juanfran2018/Ofelia-Confinement-Shear-Cell/Design/Linear/LinearStage.pdf

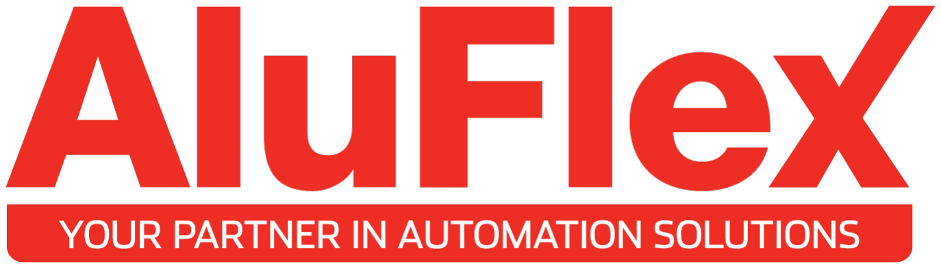
[picture p6: figure]

Artikelnummer

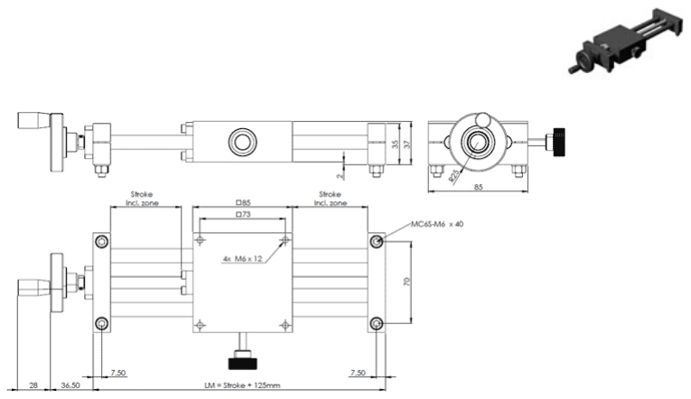
[picture p7: figure]

### JM12-S0040-TR-UR

Beskrivning

### Adjustment table JM12

Produktattribut | Värde
Trapetsgängadskruv | 10x3
Slaglängd (OBS! Inklusive överlöp) | 40
Med ratt | No

Created: 2019-04-03 13:17:58
Adress: | AluFlex System AB Lilla Garnisonsgatan 34 254 67 Helsingborg Skåne Sweden

Telefon:
Webb:
E-post:

042-380230
www.aluflex.se
orders@aluflex.se
