juanfran2018/Ofelia-Confinement-Shear-Cell/Images/ConfinementCell_3Dprinted.png

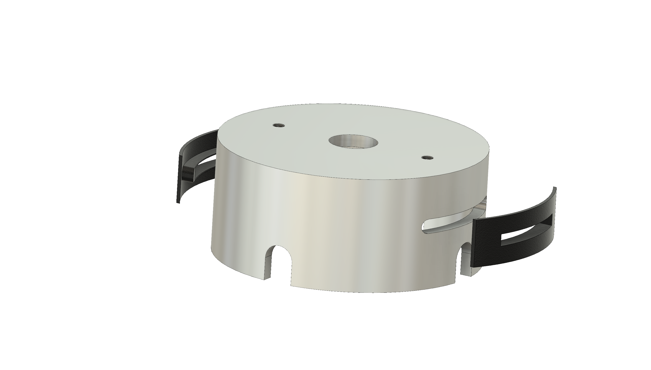
Images/ConfinementCell_3Dprinted.png
