juanfran2018/Ofelia-Confinement-Shear-Cell/Design/Linear/CaseWindow.pdf

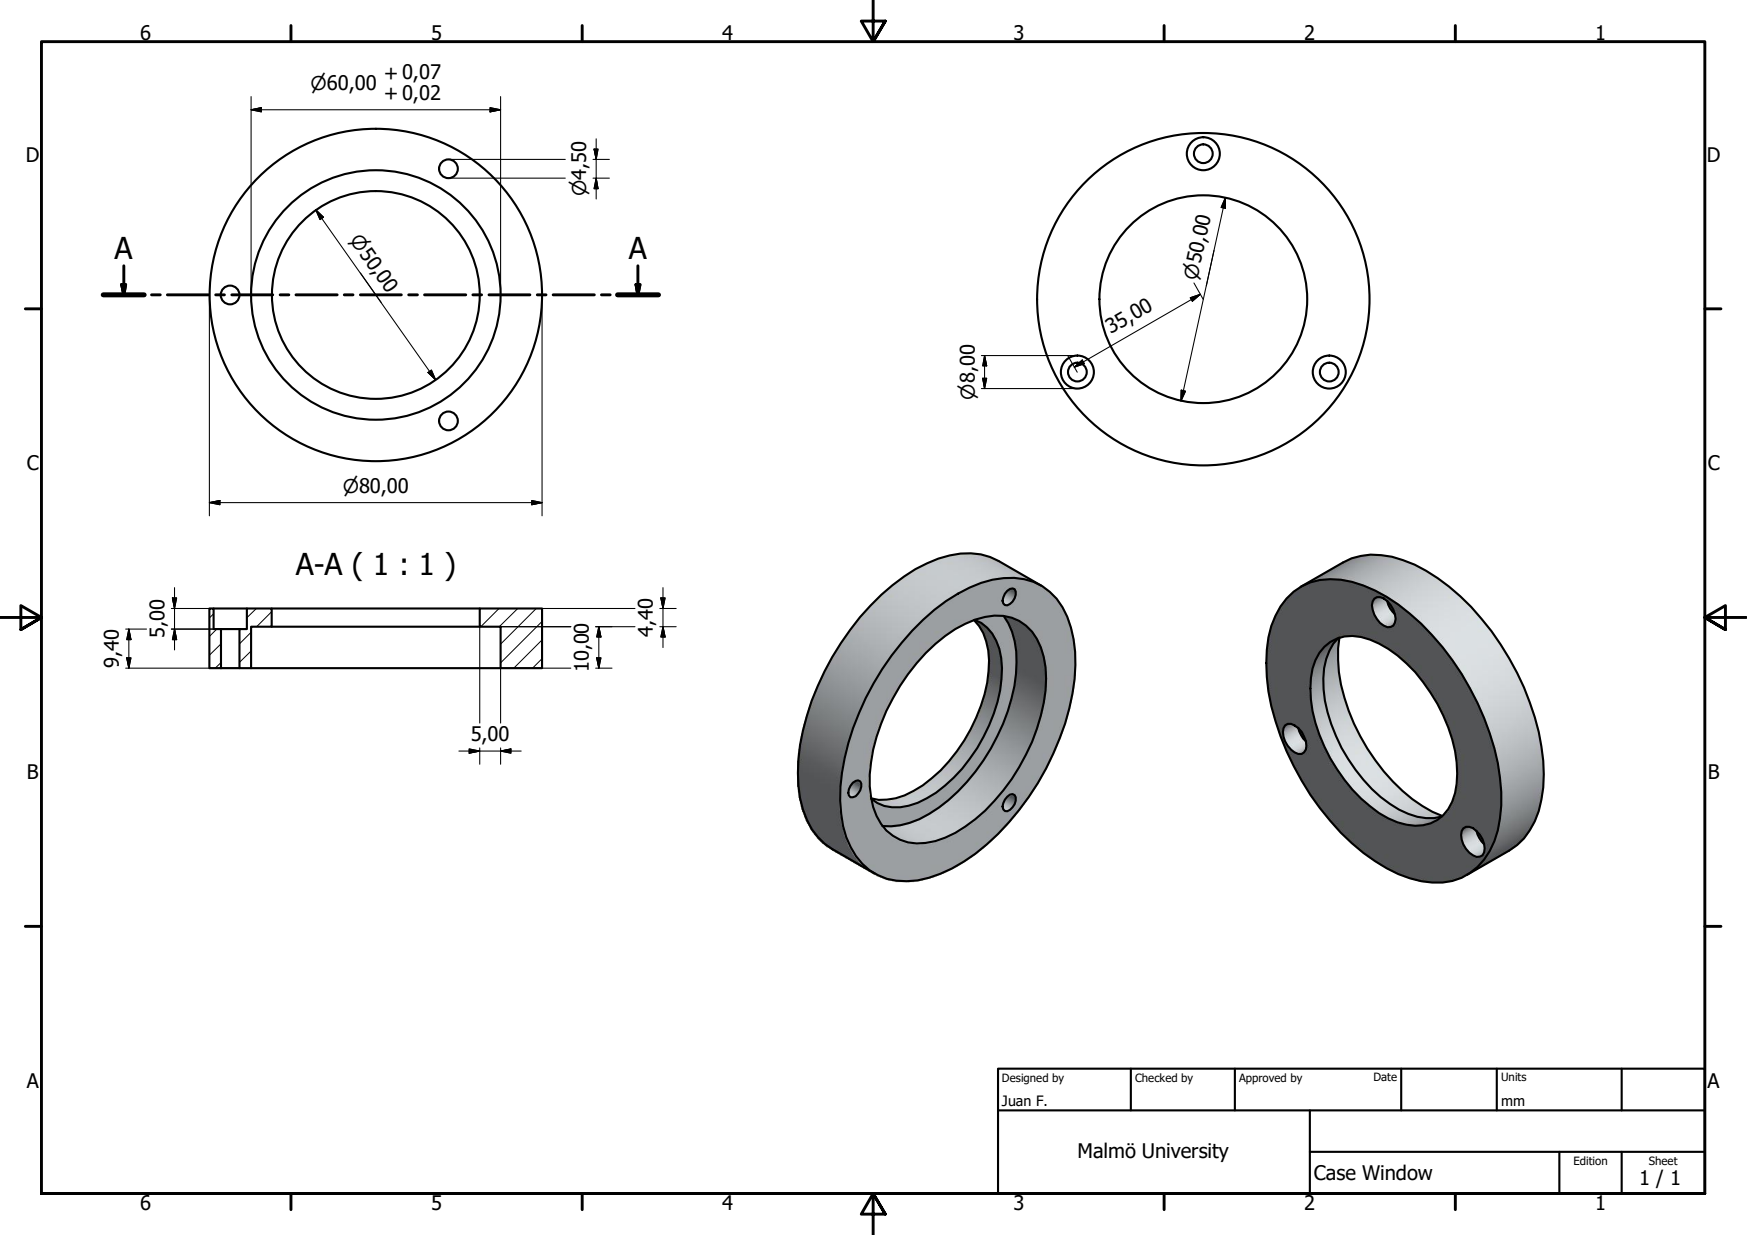
[picture p9: page 1]

Designed by Juan F. | Checked by | Approved by Date | Units mm

Malm| University

Case Window | Edition | Sheet 1 / 1
