juanfran2018/Ofelia-Confinement-Shear-Cell/Design/Linear/LinearCaseExternal.pdf

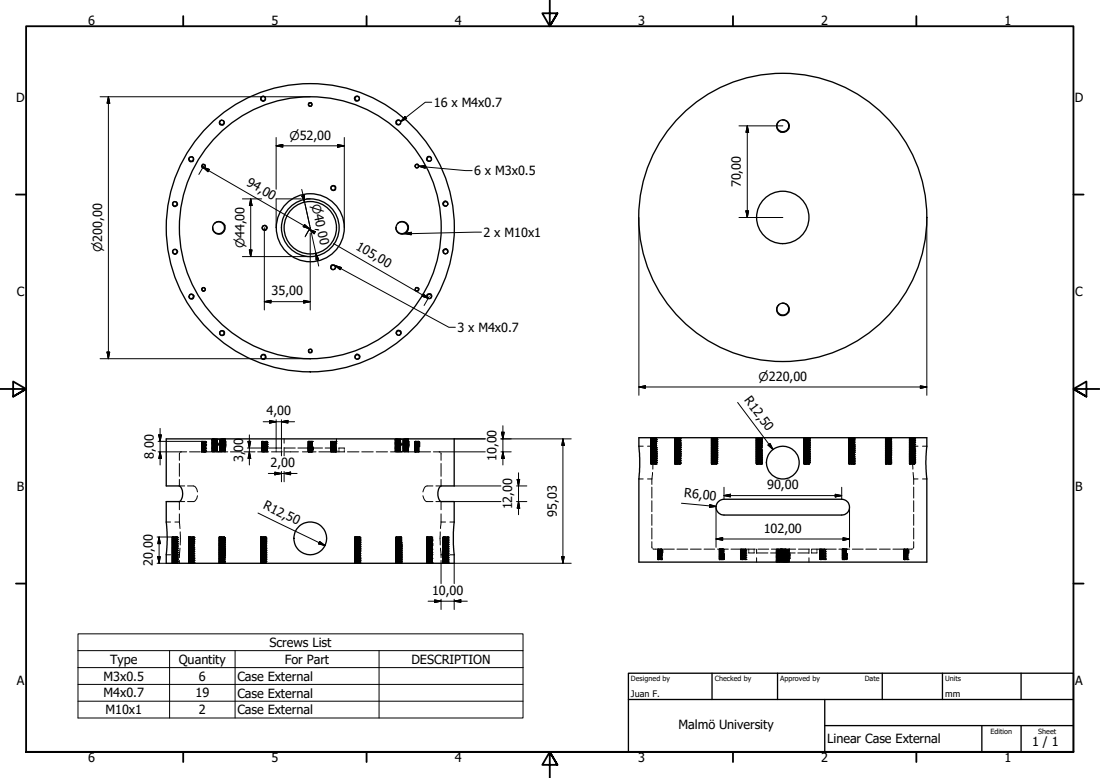
[picture p10: page 1]
Malmö University; Juan F.; Designed by; Checked by; Approved by; Units; Screws List; Type; Quantity; For Part; DESCRIPTION; Case External

Linear Case External
