juanfran2018/Ofelia-Confinement-Shear-Cell/Design/Linear/LinearCaseInternal.pdf

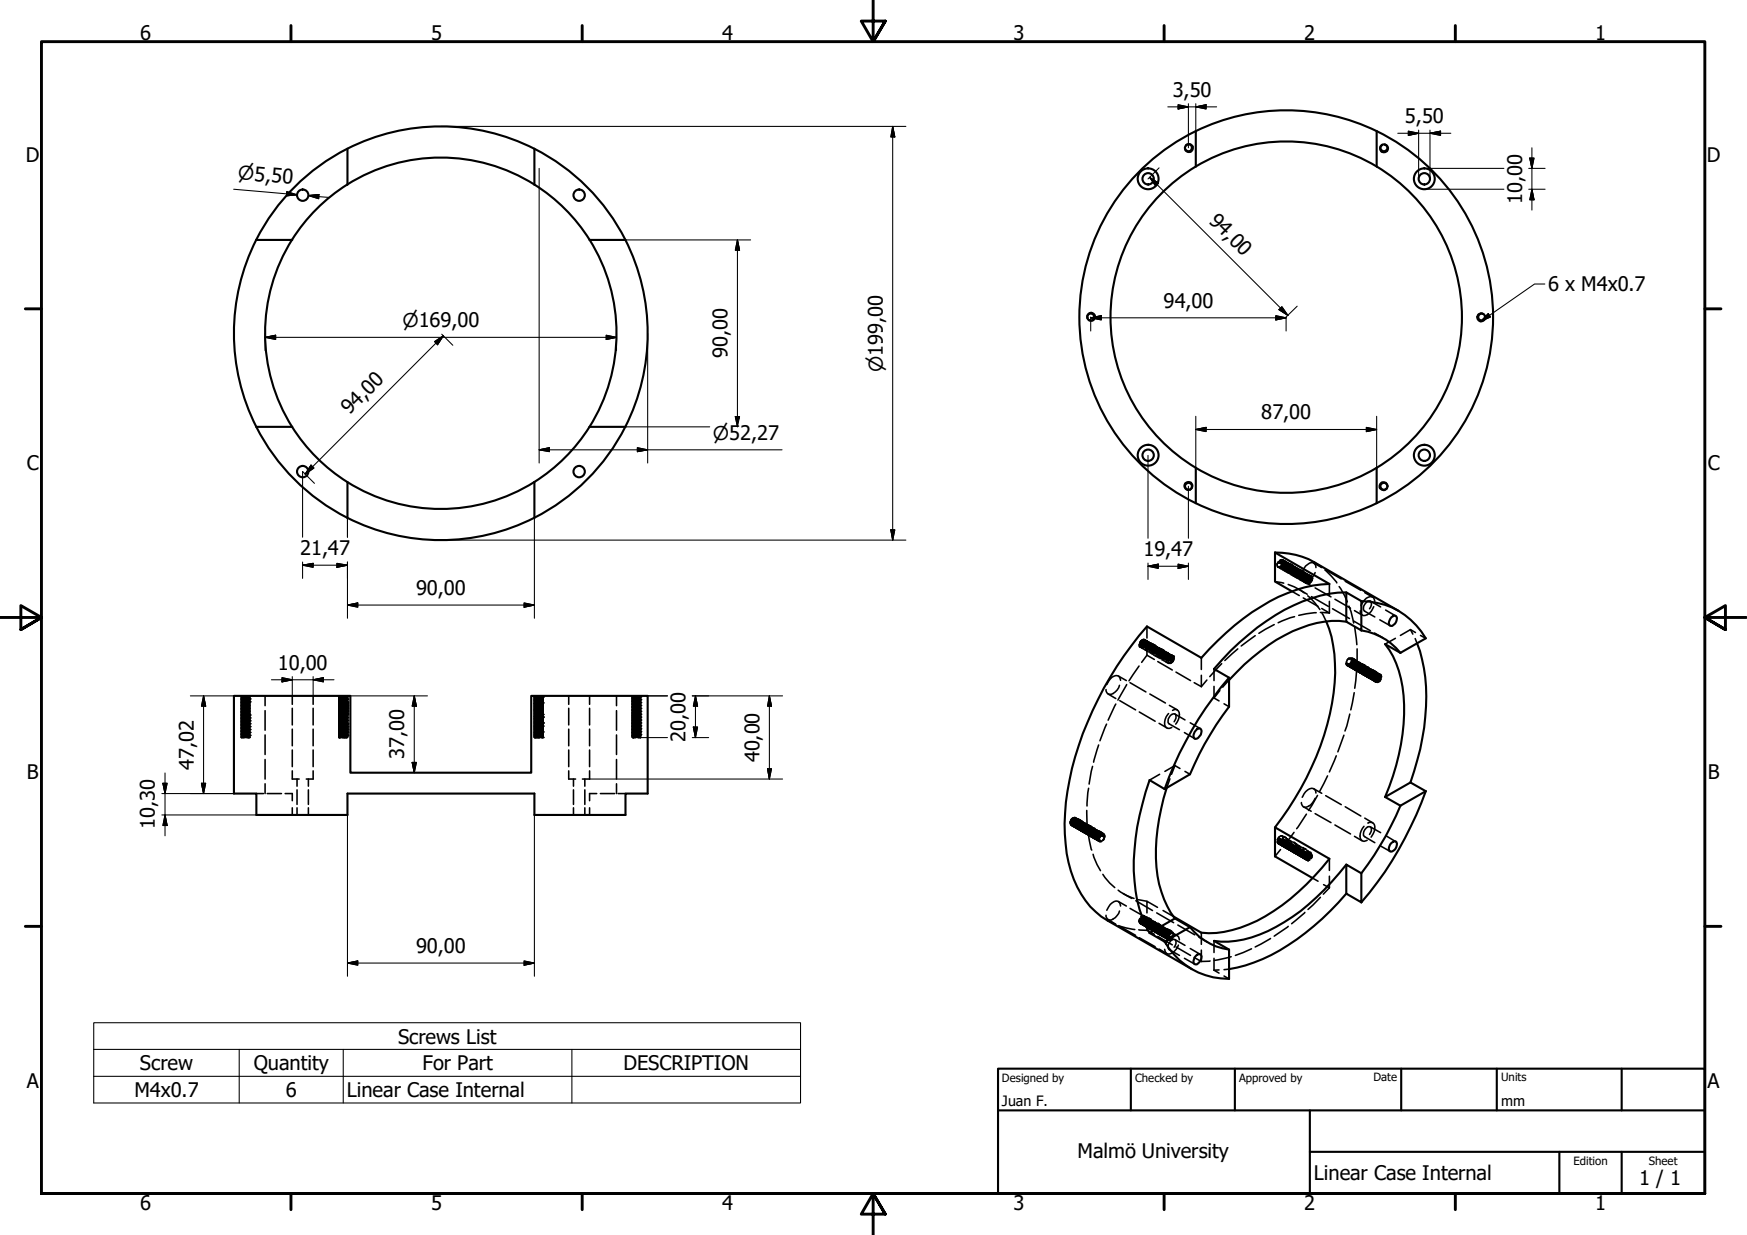
[picture p11: page 1]
Screws List

Screw | Quantity | For Part | DESCRIPTION
M4x0.7 | 6 | Linear Case Internal

Designed by Juan F. | Checked by | Approved by Date | Units mm

Malm| University

Linear Case Internal | Edition | Sheet 1 / 1
