juanfran2018/Ofelia-Confinement-Shear-Cell/Design/Linear/LinearCaseLidSink.pdf

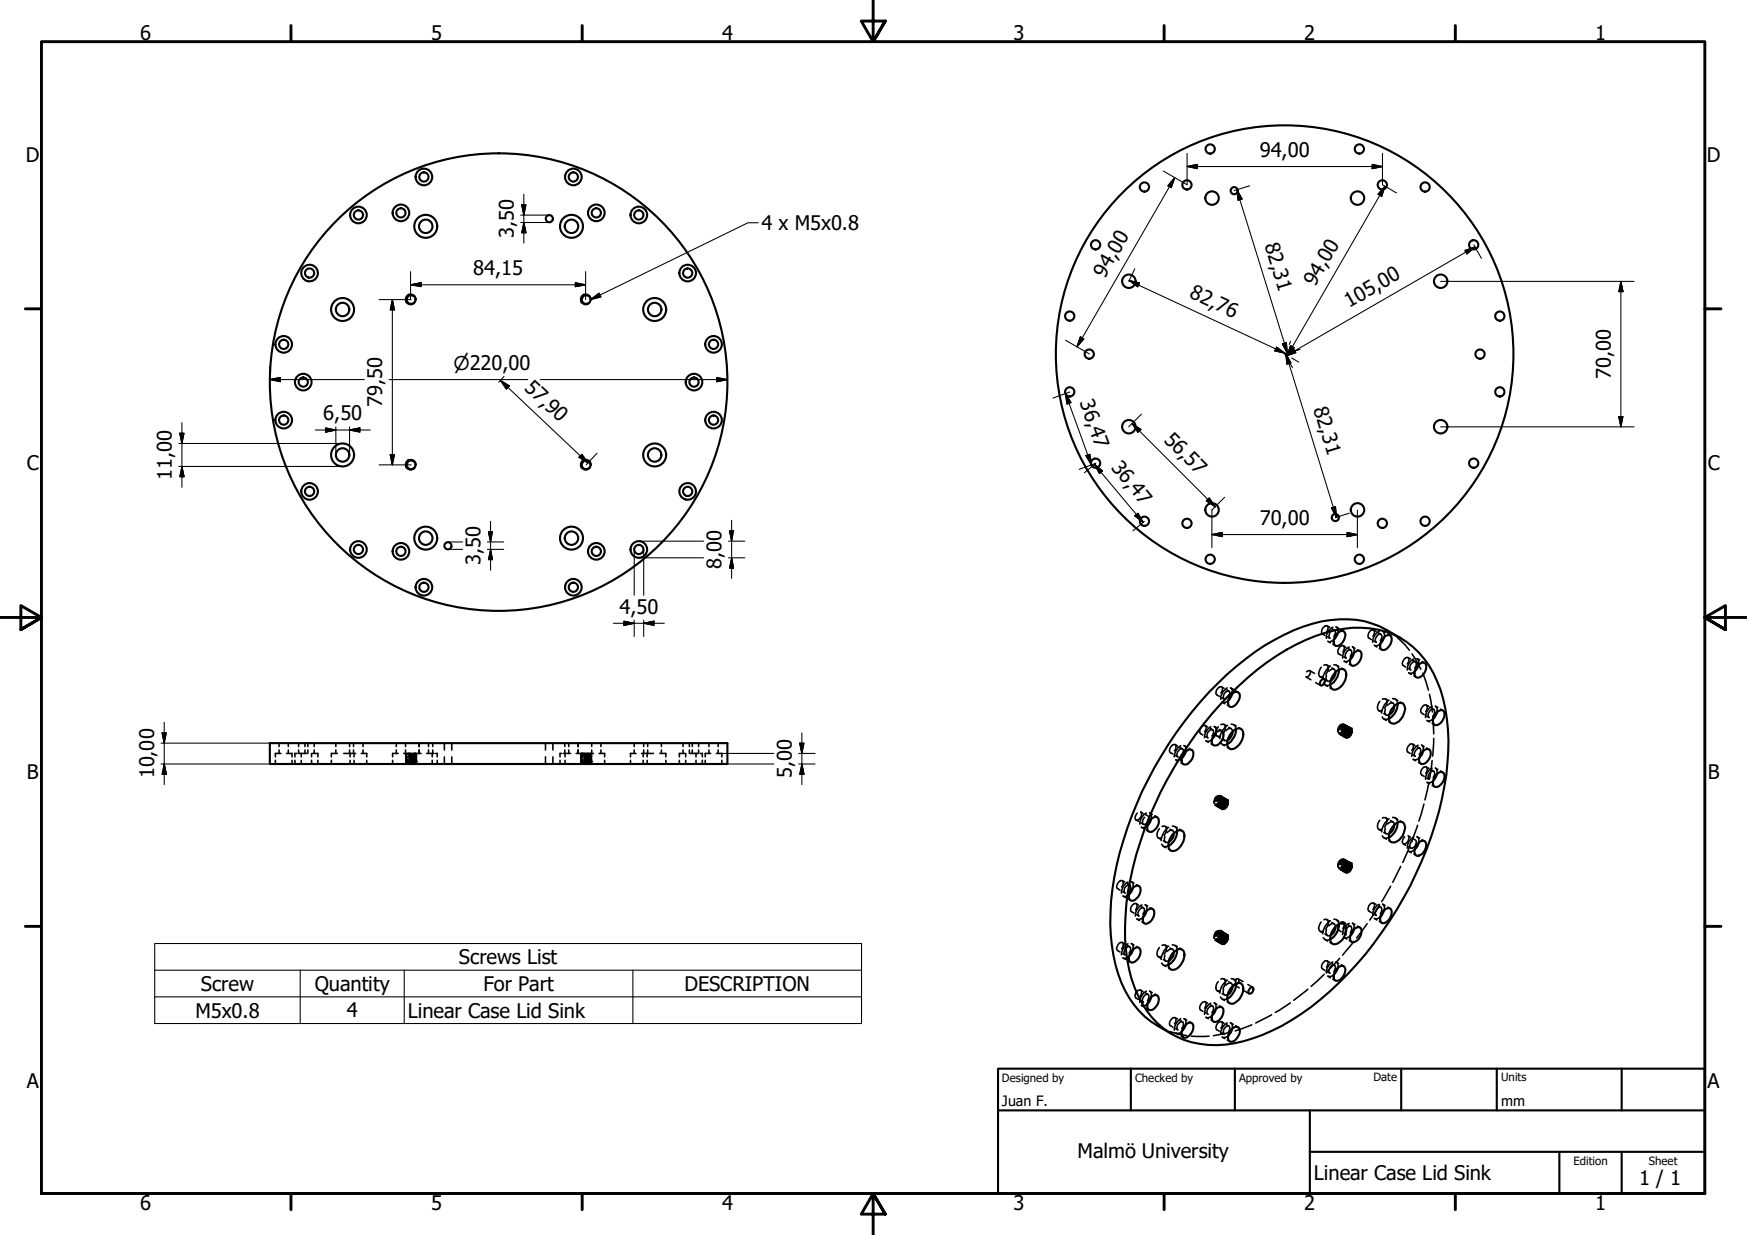
[picture p12: page 1]
Screws List

Screw | Quantity | For Part | DESCRIPTION
M5x0.8 | 4 | Linear Case Lid Sink

Designed by Juan F. | Checked by | Approved by Date | Units mm

Malm| University

Linear Case Lid Sink | Edition | Sheet 1 / 1
