juanfran2018/Ofelia-Confinement-Shear-Cell/Design/Linear/LinearSampleHolder.pdf

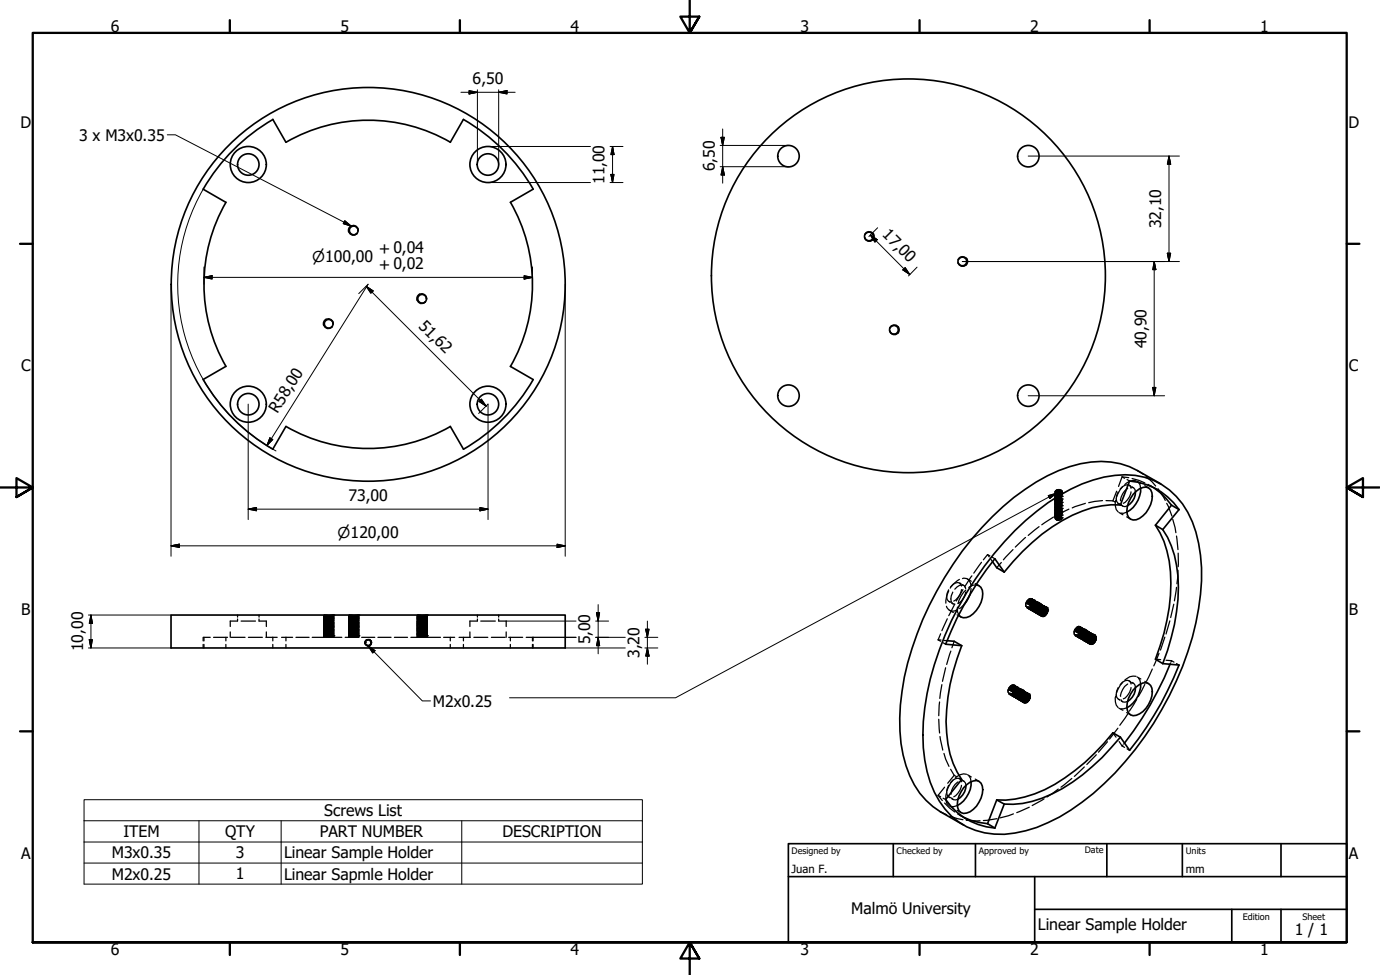
[picture p13: page 1]
Screws List; ITEM; QTY; PART NUMBER; DESCRIPTION; Linear Sample Holder; Linear Sapmle Holder; Juan F.; Designed by; Checked by; Approved by; Units

Malm| University

Linear Sample Holder | Edition | Sheet 1 / 1
