juanfran2018/Ofelia-Confinement-Shear-Cell/Design/Linear/LowerMembraneHolder.pdf

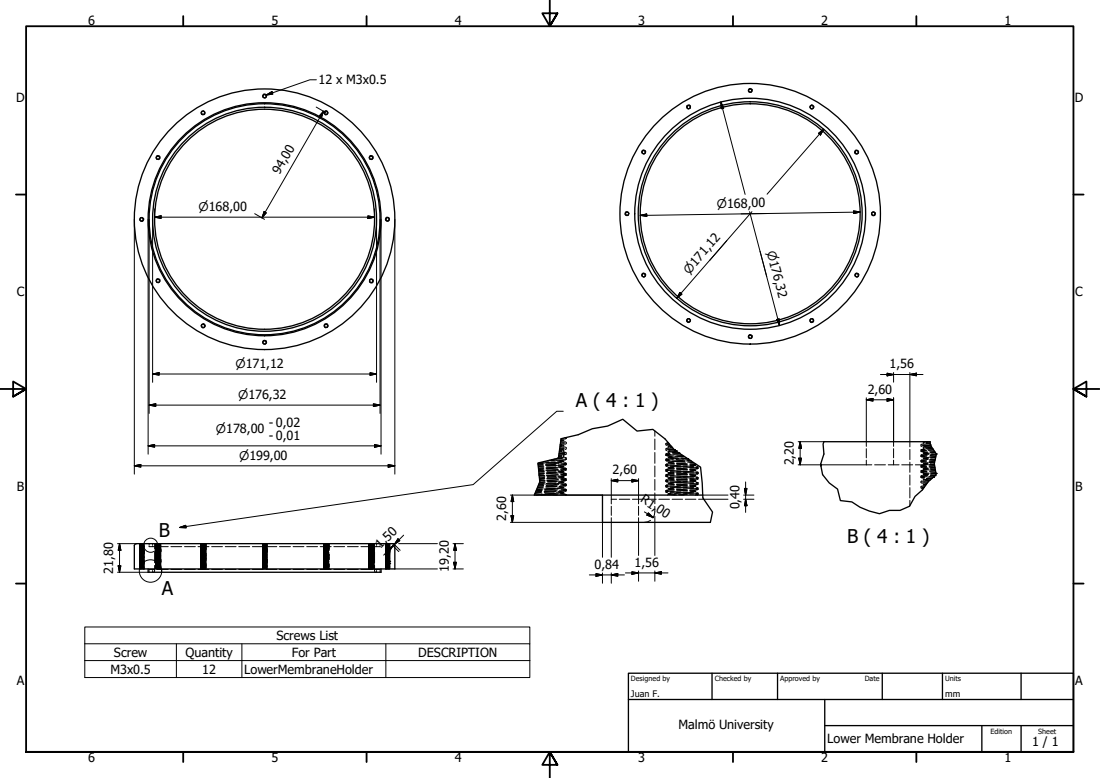
[picture p14: page 1]
Screws List; Screw; Quantity; For Part; DESCRIPTION; Malm| University; Juan F.; Designed by; Checked by; Approved by; Units

Lower Membrane Holder
