juanfran2018/Ofelia-Confinement-Shear-Cell/Design/Linear/MembraneSupport.pdf

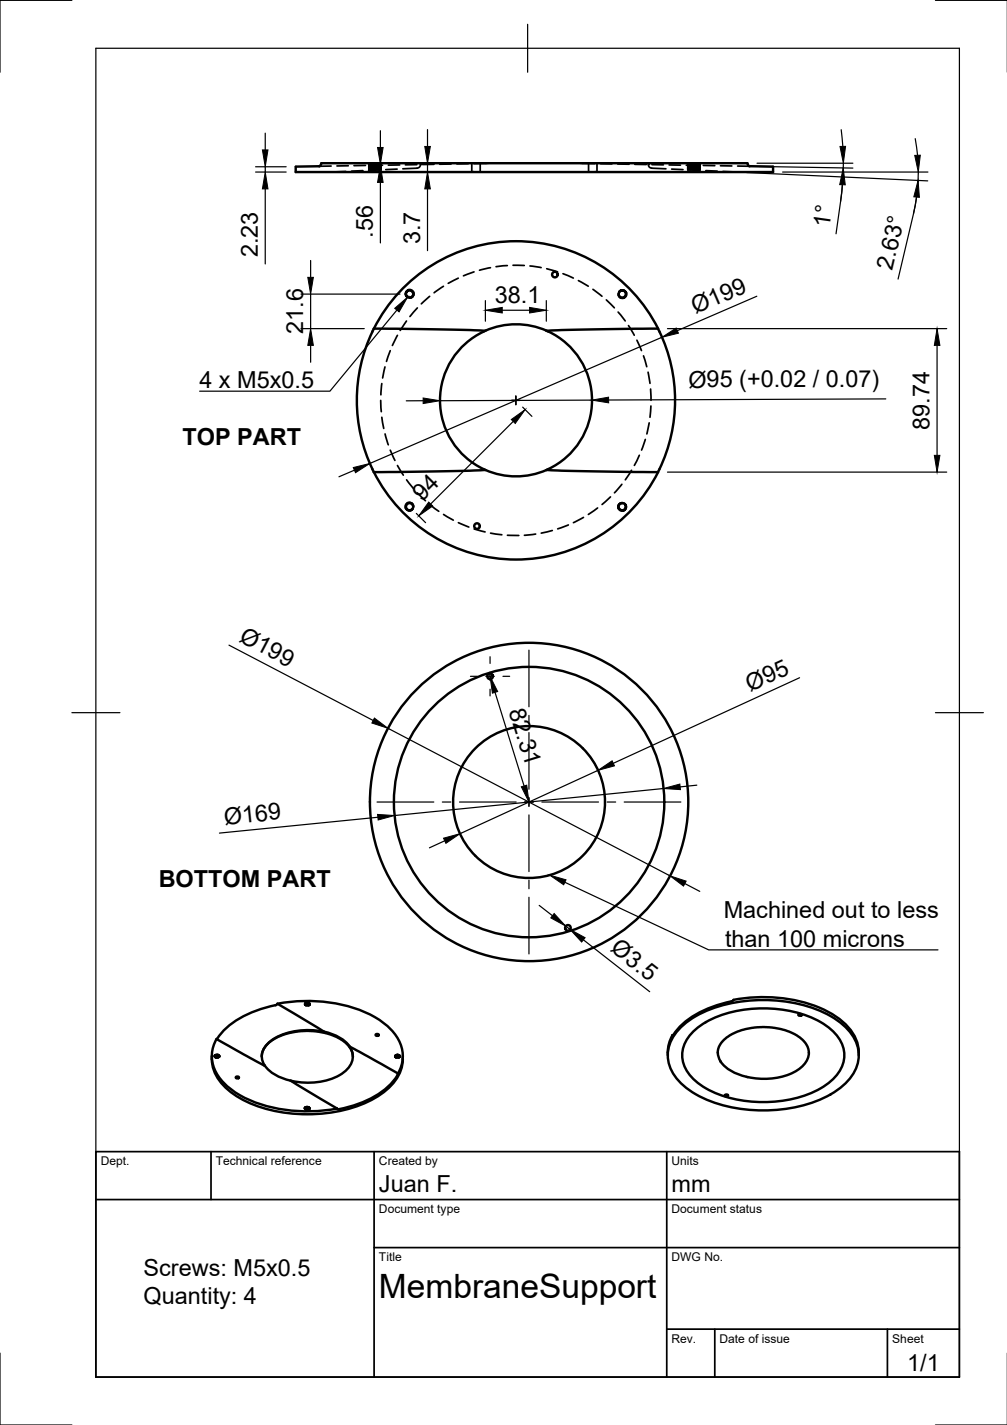
[picture p15: page 1]
TOP PART; BOTTOM PART; Quantity: 4

Machined out to less
than 100 microns

Dept. | Technical reference | Created by Juan F. | Units mm

Screws: M5x0.5 | | Document type | Document status

Title MembraneSupport | DWG No.

Rev. | Date of issue | Sheet 1/1
