juanfran2018/Ofelia-Confinement-Shear-Cell/Design/Rotational/51315.pdf

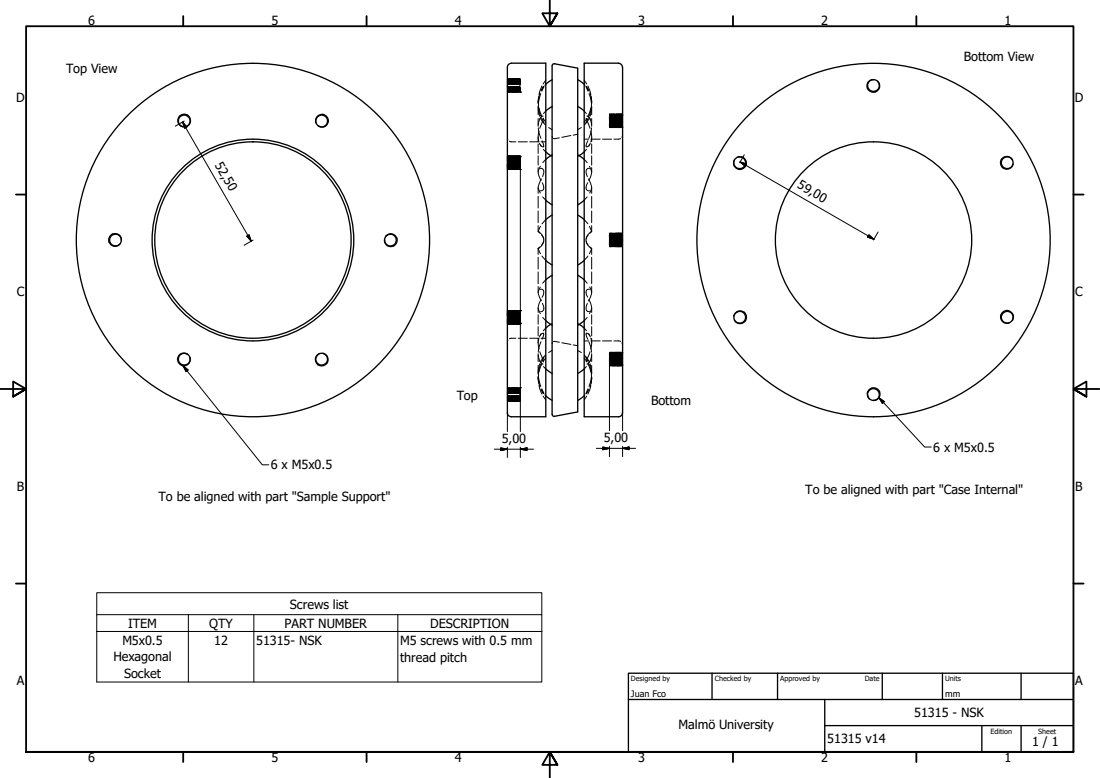
[picture p16: page 1]
Screws list; Top View; Bottom View

To be aligned with part "Case Internal"

To be aligned with part "Sample Support"

ITEM | QTY | PART NUMBER | DESCRIPTION
M5x0.5 Hexagonal Socket | 12 | 51315- NSK | M5 screws with 0.5 mm thread pitch

Designed by Juan Fco | Checked by | Approved by Date | Units mm

Malm| University | 51315 - NSK

51315 v14 | Edition | Sheet 1 / 1
