juanfran2018/Ofelia-Confinement-Shear-Cell/Design/Rotational/Bevel Gear .pdf

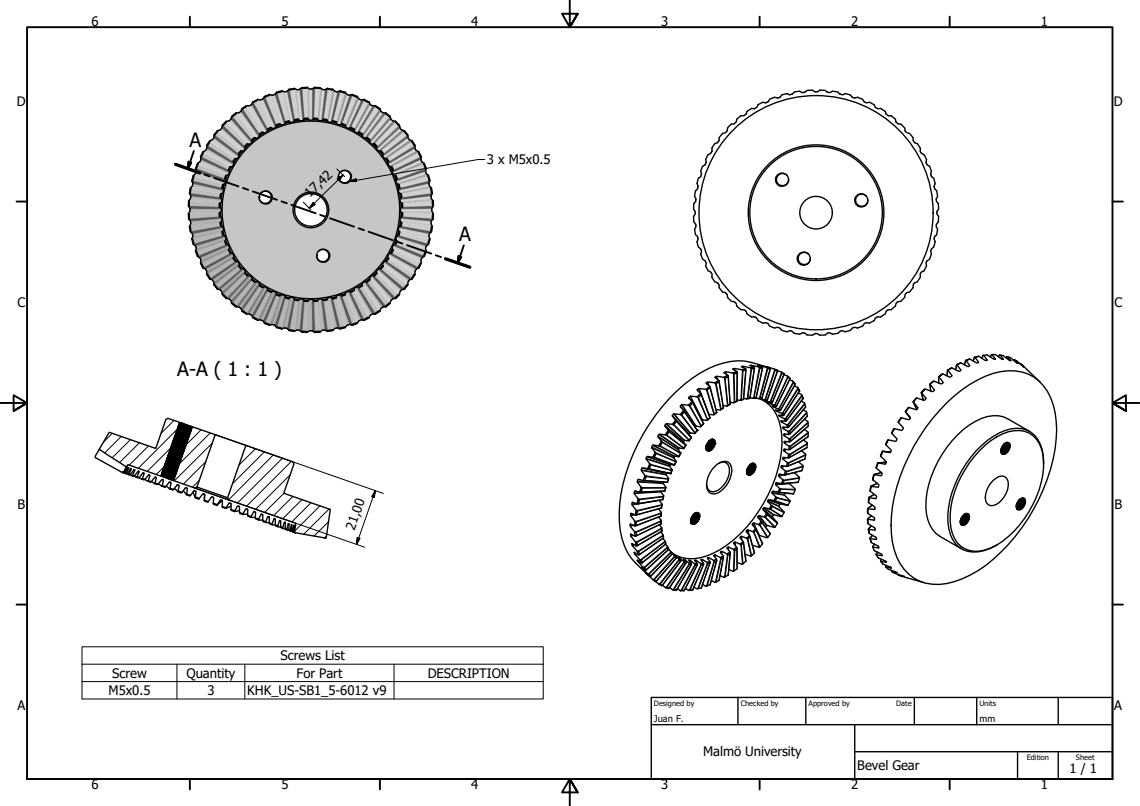
[picture p17: page 1]
Screws List

Screw | Quantity | For Part | DESCRIPTION
M5x0.5 | 3 | KHK_US-SB1_5-6012 v9

Designed by Juan F. | Checked by | Approved by Date | Units mm

Malm| University

Bevel Gear | Edition | Sheet 1 / 1
