juanfran2018/Ofelia-Confinement-Shear-Cell/Design/Rotational/CaseExternal.pdf

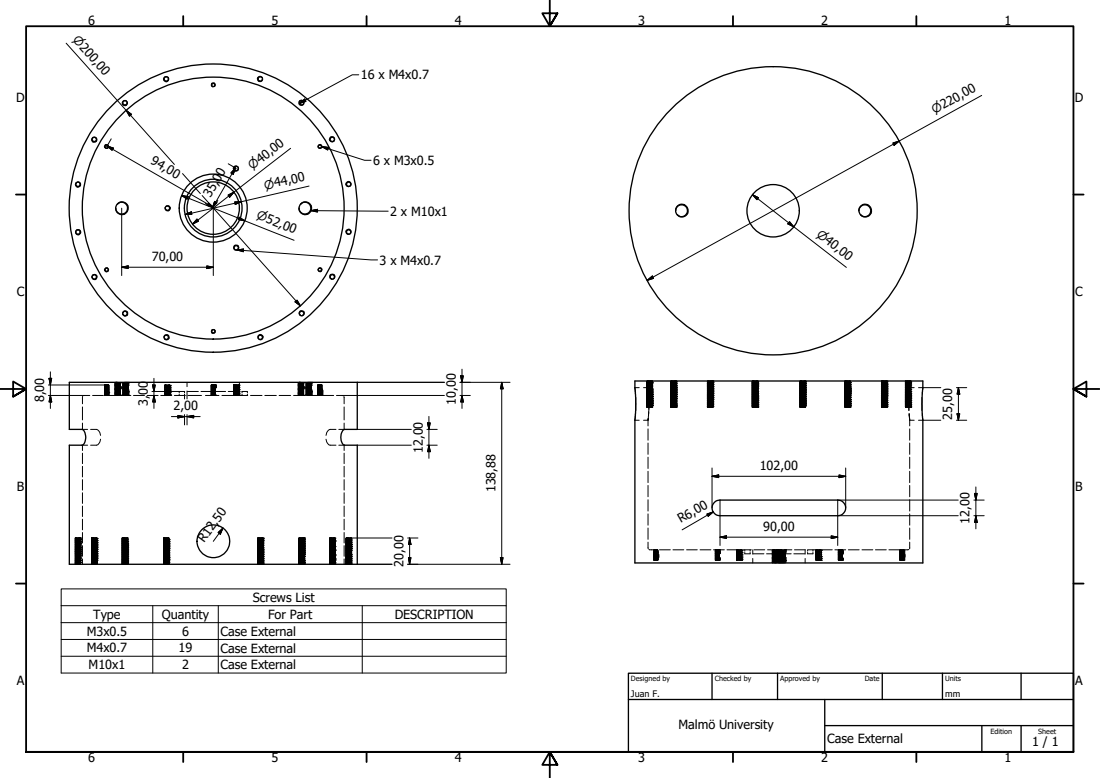
[picture p18: page 1]
Case External M10x1; Case External

al Malm| University
