juanfran2018/Ofelia-Confinement-Shear-Cell/Design/Rotational/CaseInternal.pdf

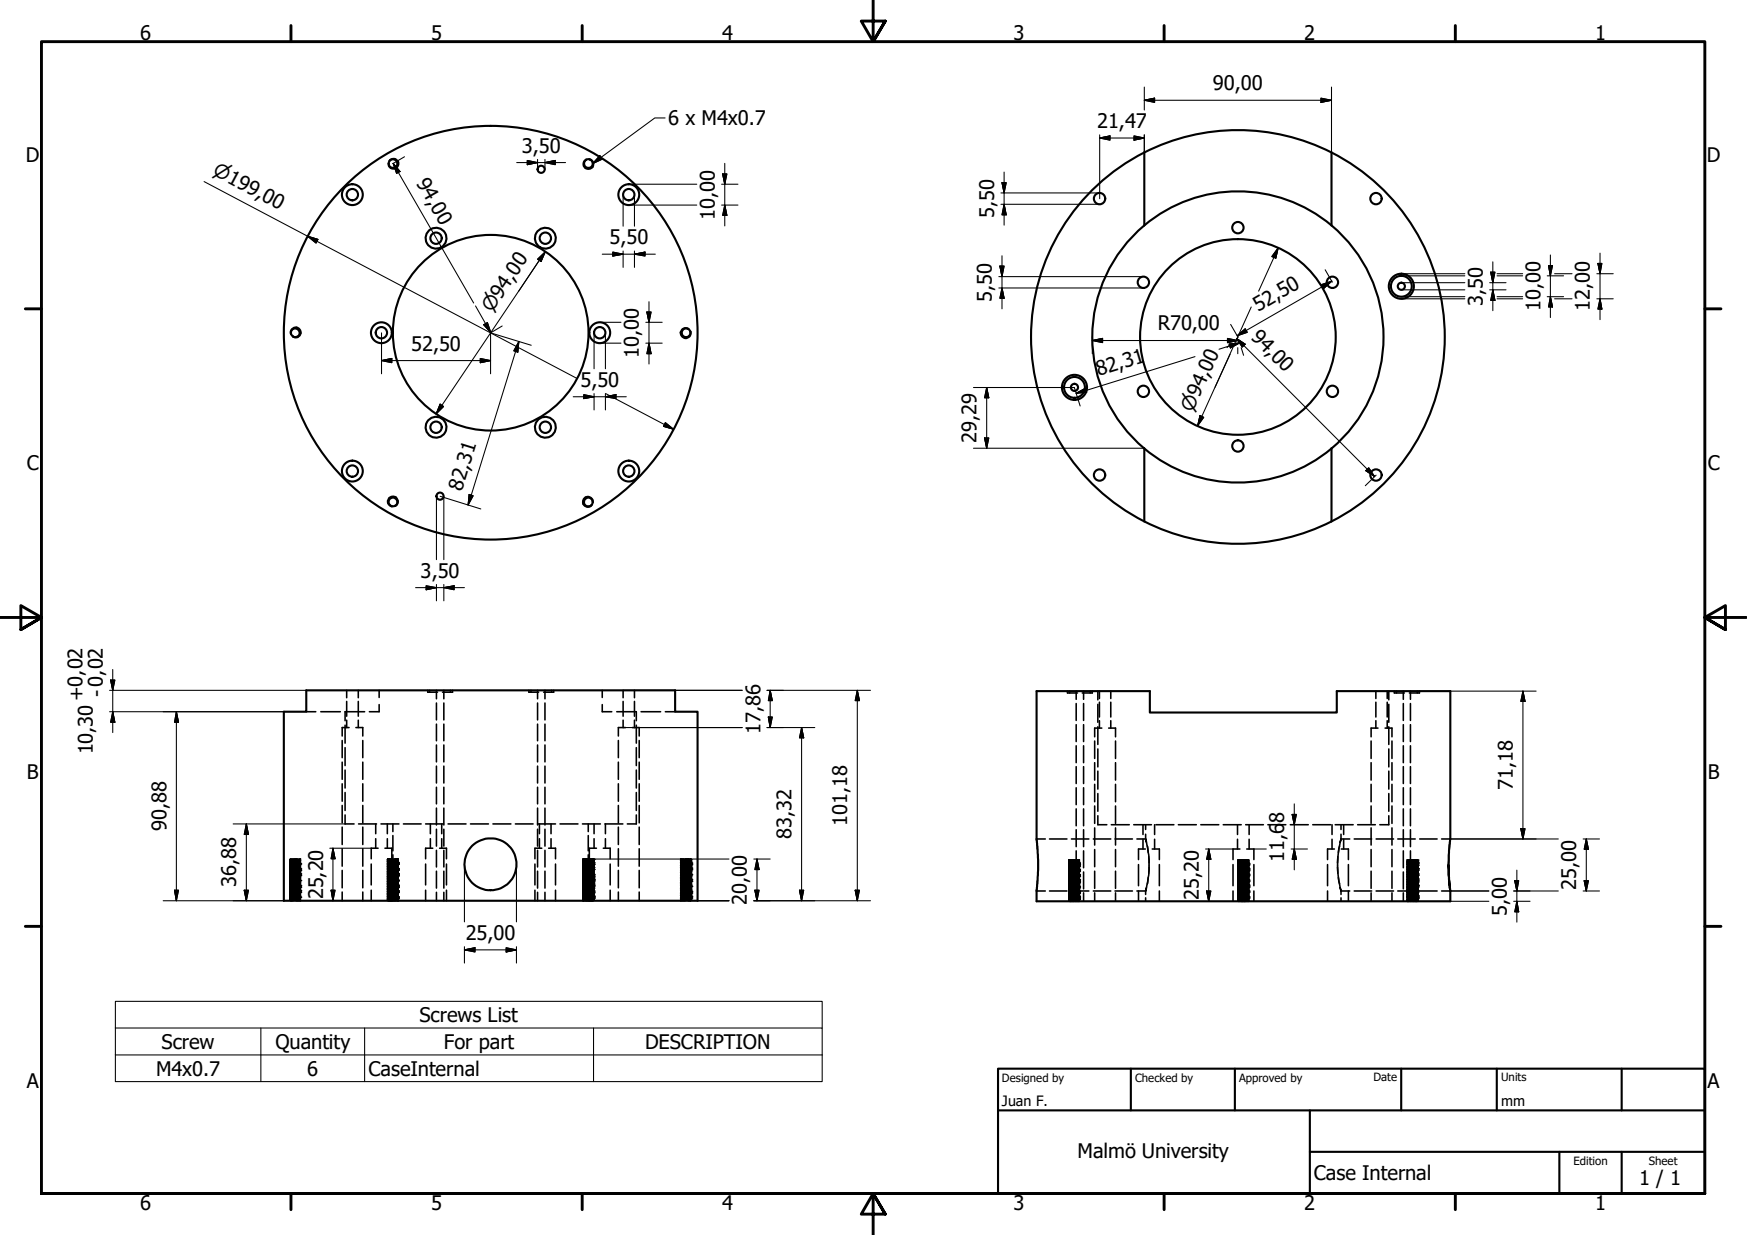
[picture p19: page 1]
Screws List; Screw; Quantity; For part; DESCRIPTION; Case Internal; Malm| University; Juan F.; Designed by; Checked by; Approved by; Units
