juanfran2018/Ofelia-Confinement-Shear-Cell/Design/Rotational/CaseLidSink.pdf

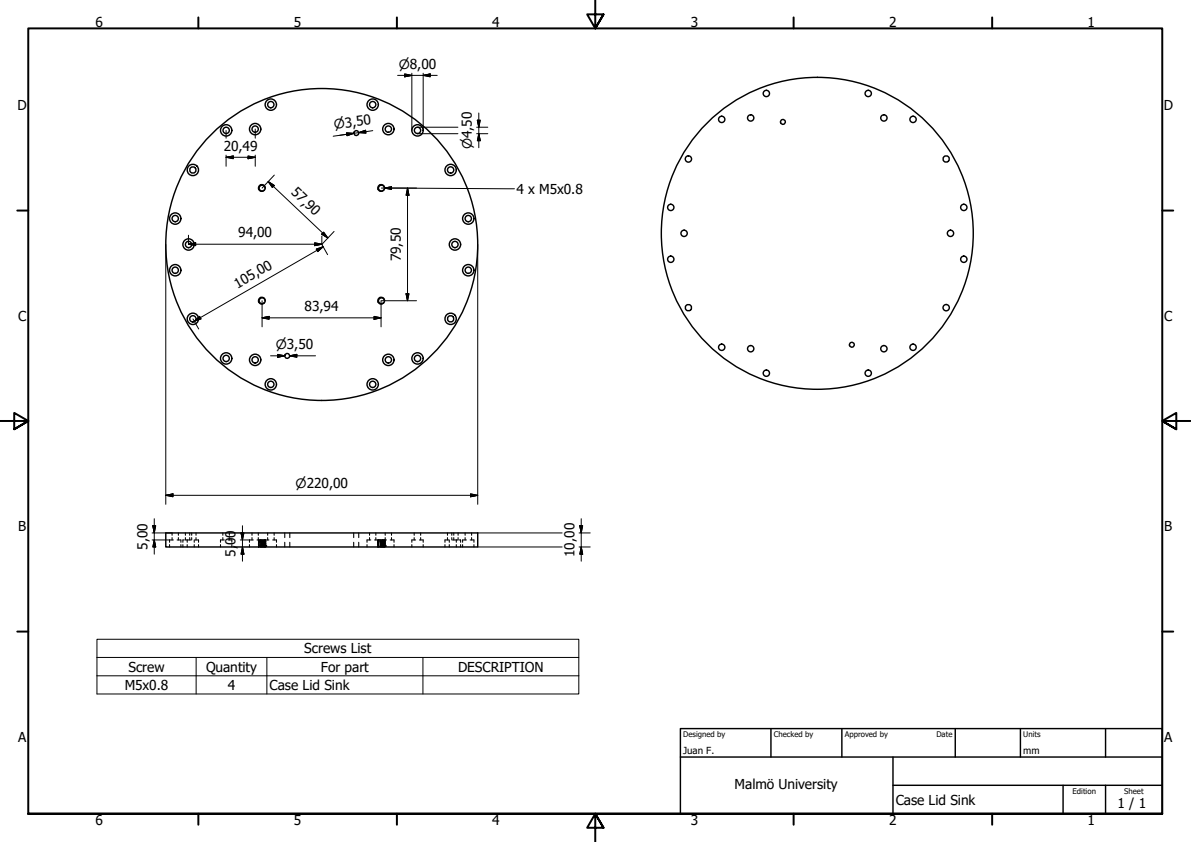
[picture p20: page 1]
Screws List

Screw | Quantity | For part | DESCRIPTION
M5x0.8 | 4 | Case Lid Sink

Designed by Juan F. | Checked by | Approved by Date | Units mm

Malmö University

Case Lid Sink | Edition | Sheet 1 / 1
