juanfran2018/Ofelia-Confinement-Shear-Cell/Design/Rotational/SampleSuportRot.pdf

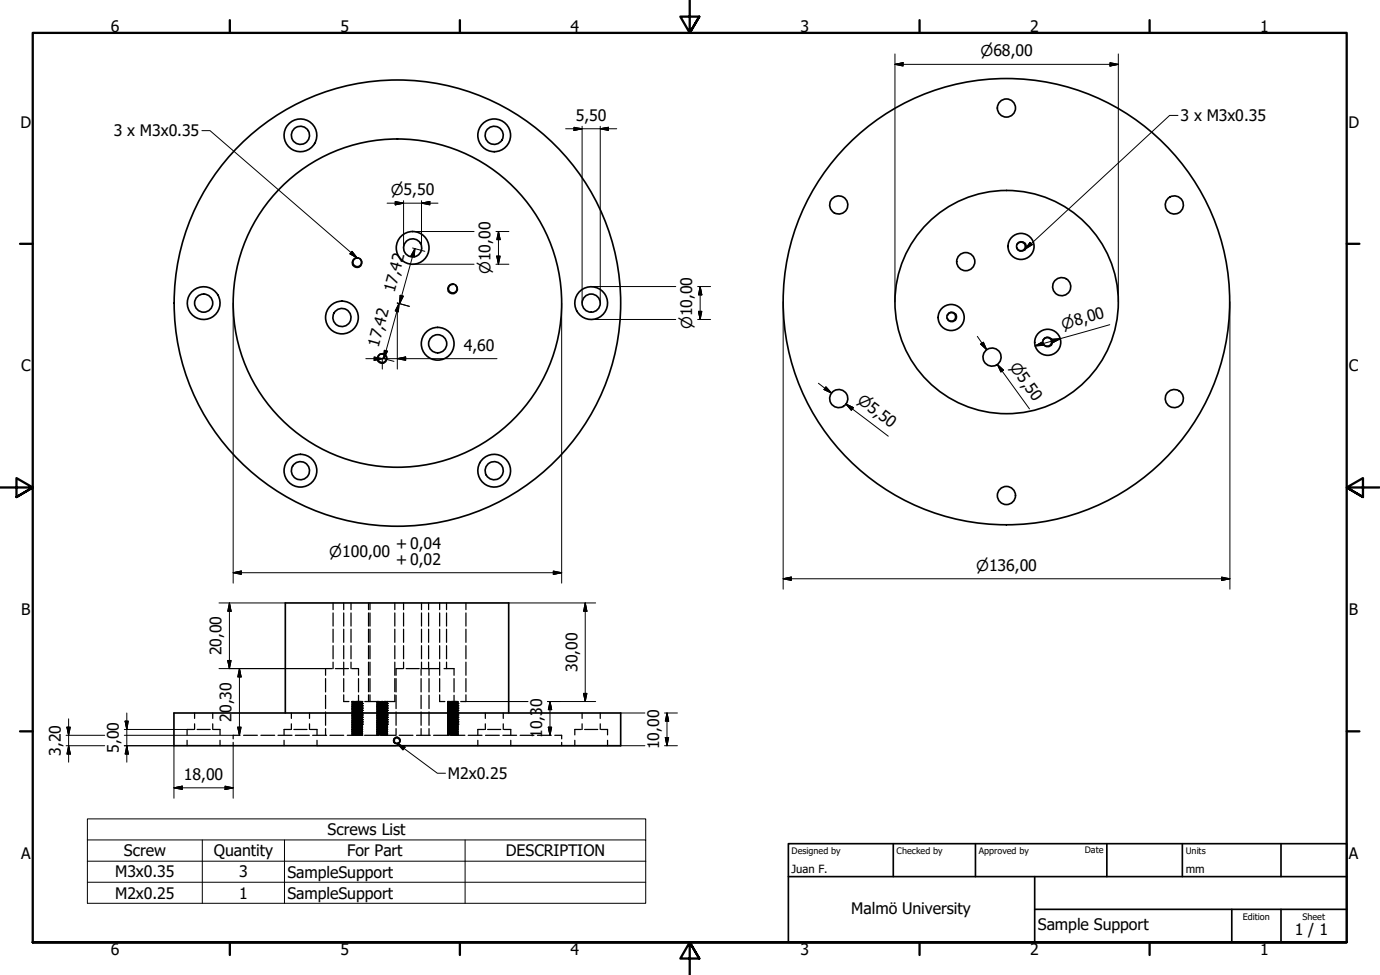
[picture p21: page 1]
Screws List

Screw | Quantity | For Part | DESCRIPTION
M3x0.35 | 3 | SampleSupport
M2x0.25 | 1 | SampleSupport

Designed by Juan F. | Checked by | Approved by Date | Units mm

Malm| University

Sample Support | Edition | Sheet 1 / 1
