juanfran2018/Ofelia-Confinement-Shear-Cell/Design/Linear/UpperMembraneHolder.pdf

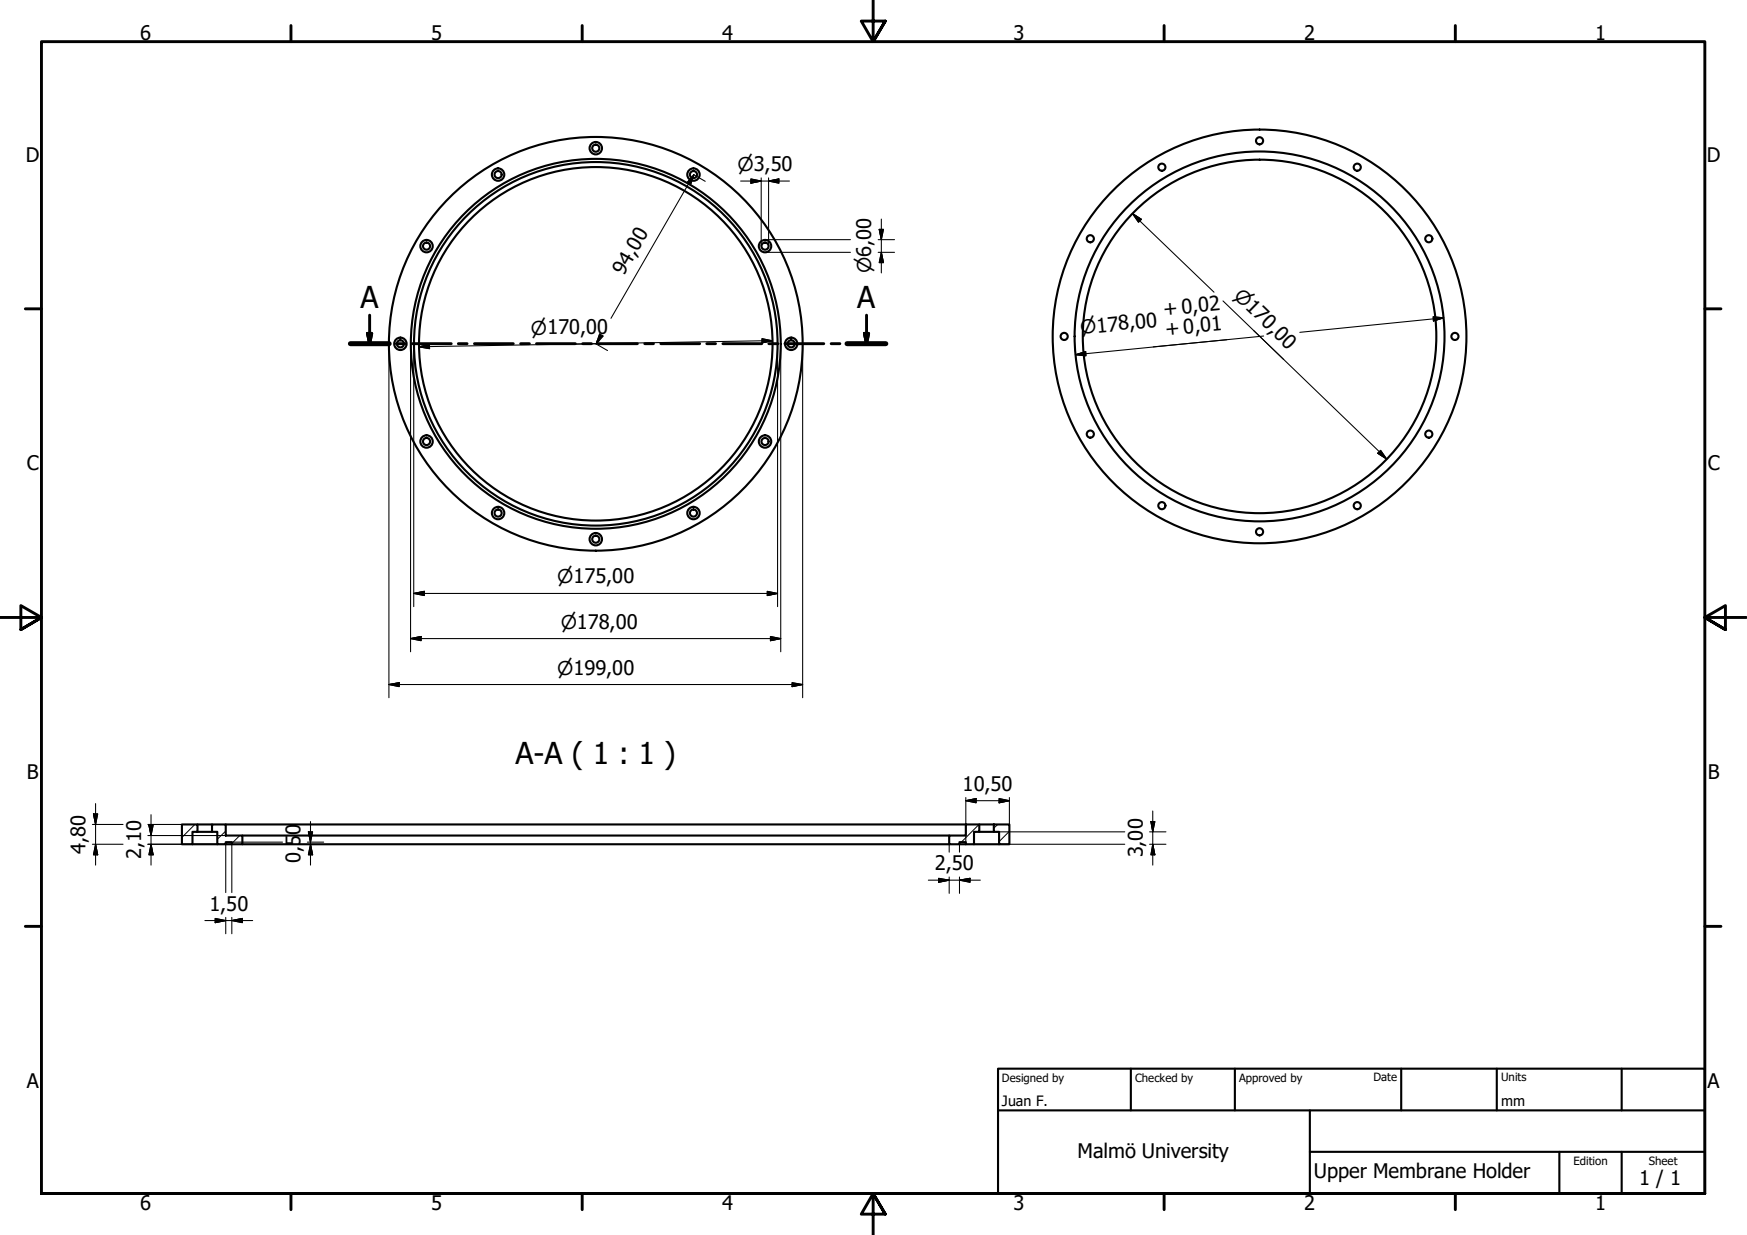
[picture p22: page 1]

Designed by Juan F. | Checked by | Approved by Date | Units mm

Malm| University

Upper Membrane Holder | Edition | Sheet 1 / 1
