juanfran2018/Ofelia-Confinement-Shear-Cell/Design/Rotational/Pinion.pdf

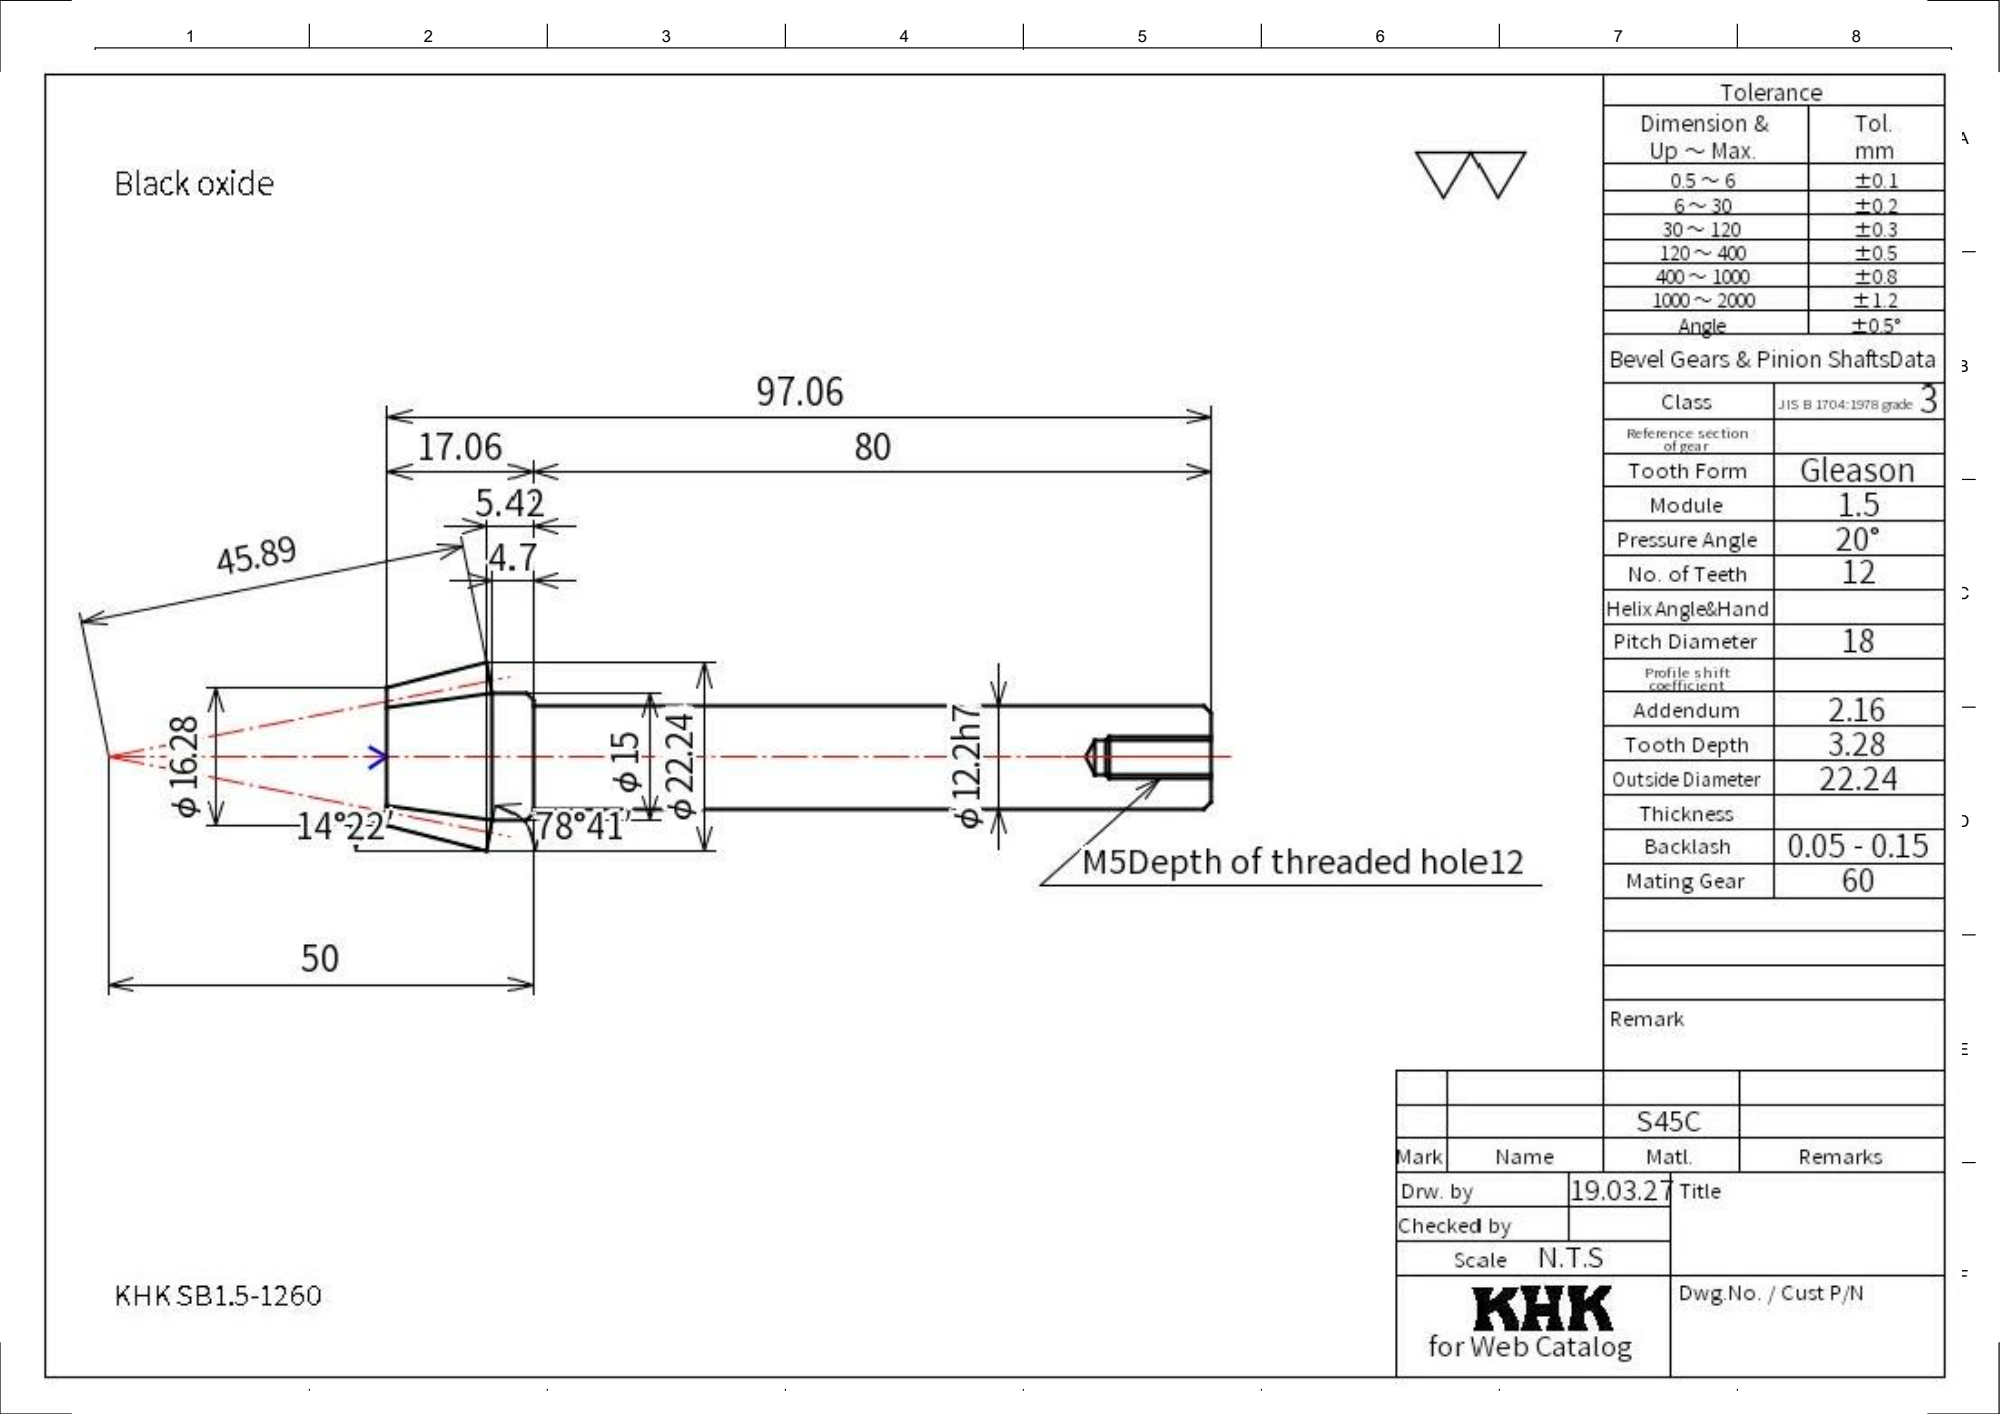
[picture p23: page 1]

Dept. | Technical reference | Created by Juan Fransisco Gonzales 02/04/2019 | Approved by

Document type | Document status

Title KHK_US-SB1_5-1260 | DWG No.

Rev. | Date of issue | Sheet 1/1
